kyhx/Multi-voltage-output-power-KYHX/PCB_PCB1_2026-10-07.pdf

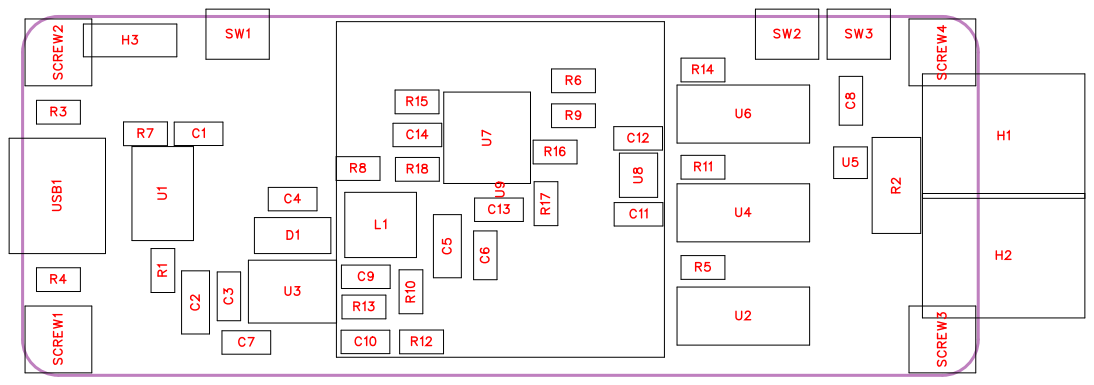
[picture p1: page 1]

No. | Quantity | Comment | Designator | Footprint | Value | Manufacture r Part | Manufacture r | Supplier Part | Supplier
1 | 1 | 1uF | C1 | C0805 | 1uF | CL21B105KBF NNNE | SAMSUNG( ) C28323 | | LCSC
2 | 1 | 22uF | C2 | C1206 | 22uF | CL31A226KAH NNNE | SAMSUNG( ) C12891 | | LCSC
3 | 2 | 100nF | C3,C6 | C0805 | 100nF | CC0805KRX7R 9BB104 | YAGEO(ýè) | C49678 | LCSC
4 | 4 | 100nF | C4,C8,C13,C14 | C0805 | 100nF | FCC0805B104 K500DT | FOJAN(Ìw) | C5137467 | LCSC
5 | 1 | 100uF | C5 | C1206 | 100uF | CL31A107MQH NNNE | SAMSUNG( ) C15008 | | LCSC
6 | 1 | 8.2nF | C7 | C0805 | 8.2nF | 0805B822K50 0NT | FH(ÎN) | C1758 | LCSC
7 | 1 | 2.2nF | C9 | C0805 | 2.2nF | 0805B222K50 0NT | FH(ÎN) | C36576 | LCSC
8 | 1 | 10pF | C10 | C0805 | 10pF | CC0805JRNPO 9BN100 | YAGEO(ýè) | C107107 | LCSC
9 | 2 | 1nF | C11,C12 | C0805 | 1nF | CC0805KRX7R 9BB102 | YAGEO(ýè) | C94121 | LCSC
10 | 1 | B340A-E3/61 T | D1 | SMA_L4.3-W2 .6-LS5.2-RD | | B340A-E3/61 T | VISHAY() | C15570 | LCSC
11 | 2 | PZ254R-12-8 P | H1,H2 | HDR-TH_8P-P 2.54-H-M-R2 -C4-S2.54 | | PZ254R-12-8 P | XFCN(tÞ) | C492432 | LCSC
12 | 1 | LAIL-PZ2.54 -3P-L | H3 | HDR-TH_3P-P 2.54-V-M-1 | | LAIL-PZ2.54 -3P-L | LAILAN(±T) | C54950604 | LCSC
13 | 1 | FXL0530-6R8 -M | L1 | IND-SMD_L5. 4-W5.2_FXL0 530 | | FXL0530-6R8 -M | cjiang(•_®5) Tj | T* () C177249 | LCSC
14 | 2 | 10k© | R1,R8 | R0805 | 10k© | FRC0805F100 2TS | FOJAN(Ìw) | C2907219 | LCSC
15 | 1 | 20m© | R2 | R2512 | 20m© | CSM2512FT20 L0 | SEI(Stackpo) Tj | T* (le) Tj T* (Electronics) Tj | LCSC | T* (Inc.) C346458
16 | 2 | 5.1k© | R3,R4 | R0805 | 5.1k© | 0805W8F5101 T5E | UNI-ROYAL(š) Tj | T* (ð) C27834 | LCSC
17 | 3 | 330© | R5,R11,R14 | R0805 | 330© | 0805W8F3300 T5E | UNI-ROYAL(š) Tj | T* (ð) C17630 | LCSC
18 | 3 | 10k© | R6,R15,R18 | R0805 | 10k© | 0805W8F1002 T5E | UNI-ROYAL(š) Tj | T* (ð) C17414 | LCSC
19 | 1 | 1k© | R7 | R0805 | 1k© | ERJPB6B1001 V | PANASONIC(~) Tj | T* () C413712 | LCSC
20 | 1 | 3.3k© | R9 | R0805 | 3.3k© | 0805W8F3301 T5E | UNI-ROYAL(š) Tj | T* (ð) C26010 | LCSC
21 | 1 | 10.2k© | R10 | R0805 | 10.2k© | FRC0805F102 2TS | FOJAN(Ìw) | C2933282 | LCSC

22 | 1 | 3.24k© | R12 | R0805 | 3.24k© | 0805W8F3241 T5E | UNI-ROYAL(š) Tj | T* (ð) C17609 | LCSC
23 | 1 | 13.7k© | R13 | R0805 | 13.7k© | 0805W8F1372 T5E | UNI-ROYAL(š) Tj | T* (ð) C17448 | LCSC
24 | 2 | 4.7k© | R16,R17 | R0805 | 4.7k© | FRC0805J472 TS | FOJAN(Ìw) | C2907326 | LCSC
25 | 4 | M3º | SCREW1,SCREW2,SCREW3,SCR EW4 | M3º
26 | 3 | HX TS24CA-H3.8 160gf | SW1,SW2,SW3 | SW-SMD_TS24 CA | | HX TS24CA-H3.8 160gf | hanxia(é) | C25168830 | LCSC
27 | 1 | CH224K | U1 | ESSOP-10_L4 .9-W3.9-P1. 0-LS6.0-TL-EP | | CH224K | WCH(W¬•R) | C970725 | LCSC
28 | 3 | GAQY212GHAU2,U4,U6 | | SMD-4_L6.5-W4.6-P2.54-LS9.6-TL-1 | | GAQY212GHASUPSiC(ýv®J) Tj | | T* (üS) C19271987 | LCSC
29 | 1 | TPS54331DR U3 | | SOIC-8_L5.0 -W4.0-P1.27 -LS6.0-BL | | TPS54331DR | TI(·Þêh) | C9865 | LCSC
30 | 1 | INA199A1DCK R | U5 | SC-70-6_L2. 2-W1.3-P0.6 5-LS2.1-BR | | INA199A1DCK R | TI(·Þêh) | C59135 | LCSC
31 | 1 | STM32F070F6 P6 | U7 | TSSOP-20_L6 .5-W4.4-P0. 65-LS6.4-BL | | STM32F070F6 P6 | ST(ÕJüS) | C86951 | LCSC
32 | 1 | TLV75718PDB VR | U8 | SOT-23-5_L3 .0-W1.7-P0. 95-LS2.8-BR | | TLV75718PDB VR | TI(·Þêh) | C507270 | LCSC
33 | 1 | HS96L03W2C0 3 | U9 | OLED-TH_L27 .8-W27.2-P2 .54_C990003 3791 | | HS96L03W2C0 3 | HS(I) | C5248080 | LCSC
34 | 1 | TYPE-C16PINUSB1 | | USB-C-SMD_T YPE-C16PIN | | TYPE-C16PINSHOU | HAN(–é) | C393939 | LCSC

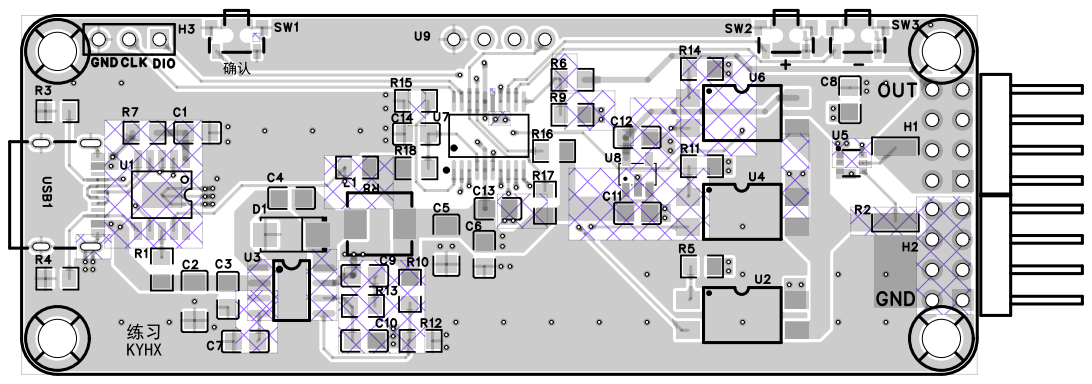
[picture p2: page 5]

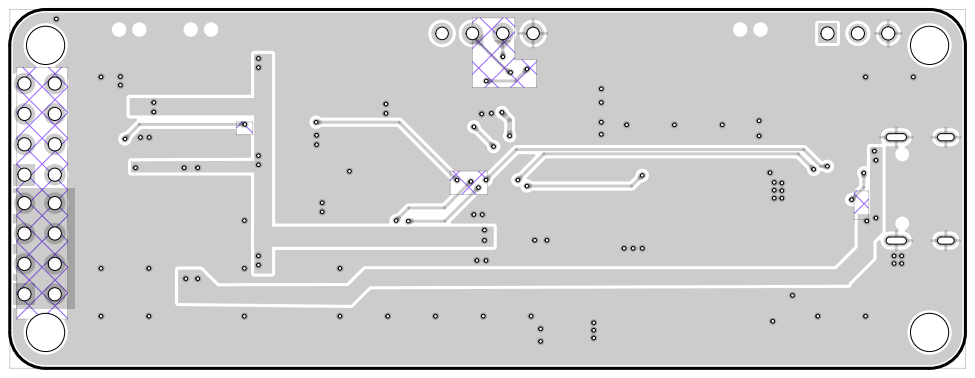
[picture p3: page 6]

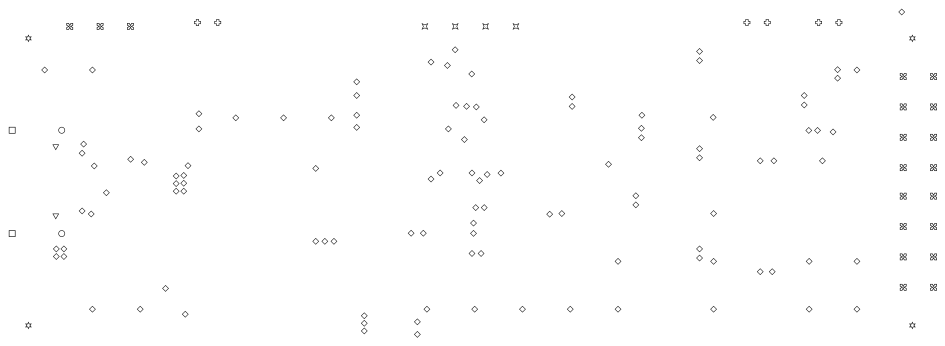
[picture p4: page 7]
