kyhx/Multi-voltage-output-power-KYHX/数字电源学习板原理图.pdf

| | | GND | A1B12 VBUS A4B9 CC1 A5 DP1 A6 DN1 A7 SBU1 A8 CC2 B5 DP2 B6 DN2 B7 SBU2 B8 VBUS B4A9 GND B1A12 SHELL 1 | | | | | | | | | 50V | | 1uF | | PG 10 | | DM | 5 | | | | R0805 | | | | R5 | | U2 | | | VBUS | | | R2512 | | R6 | | | | | 7 8

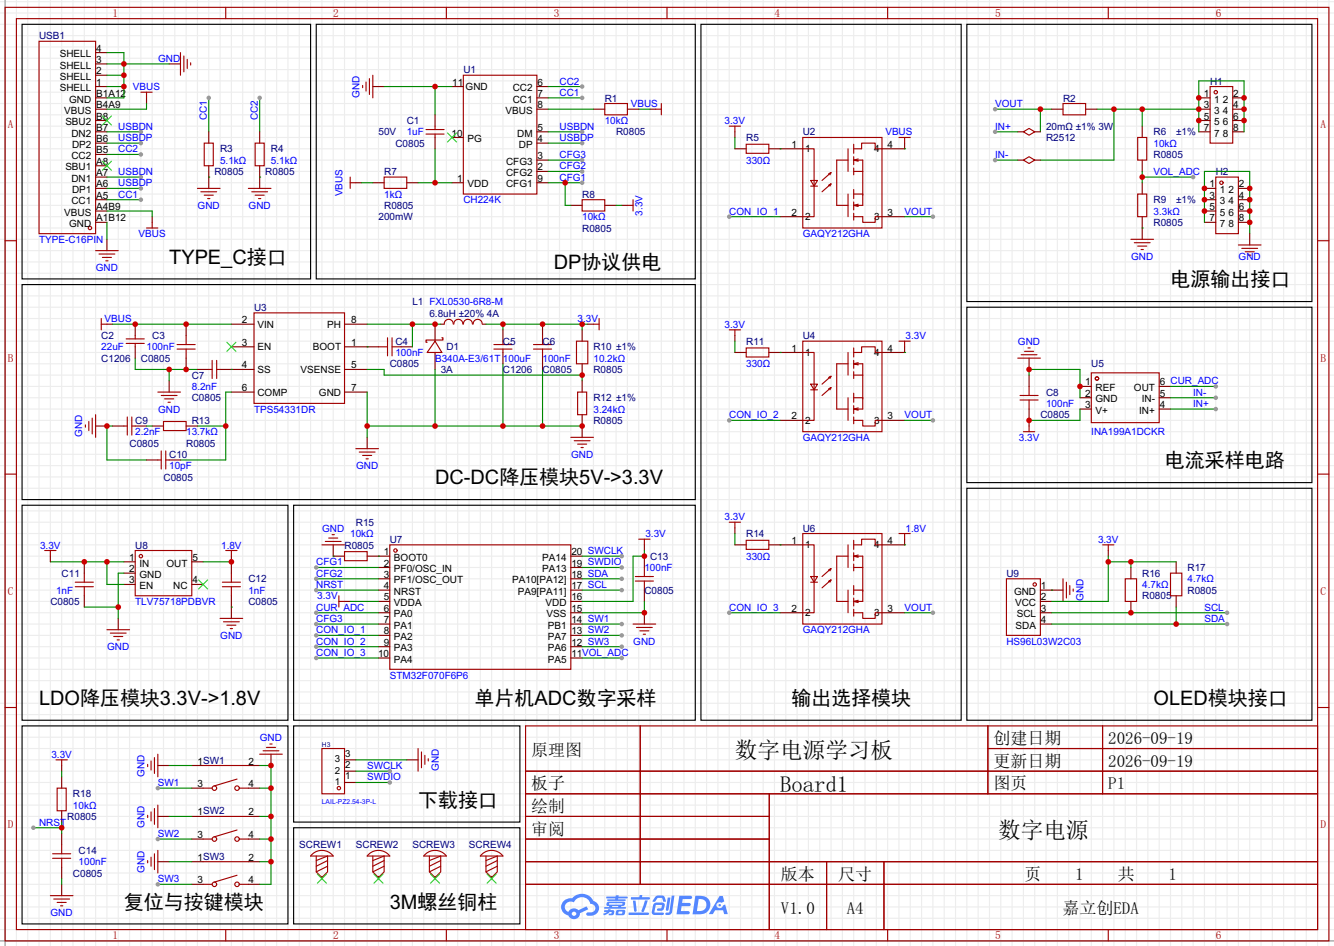
[picture p5: page 1]

USB1
SHELL | 4
SHELL | 3 | | | | U1
SHELL | 2 | | | | | | | | CC2 | | | | | H1

VBUS | | | GND 11 | CC2 | 6 | | | | | 1 | | 2

CC1 | 7 | | | R1 | | VBUS | | | | | | | | | | VOUT | | R2 | | | | 3 | | 1 2 | 4
VBUS | | 8 | | | | | | | | | | | | | | | | | | | | | 5 | | 3 4 | 6

A | | | | | USBDN | | | | | | | | | | C1 | | | | | | USBDN | | 10kΩ | | | 3.3V | | | | | | | | | IN+ | 20mΩ ±1% 3W | | | | | 7 | | 5 6 | 8 | | A

USBDP | | | | | | | | | | | | | | | | USBDP
CC2
USBDN | | | R0805 | | | R0805 | | R7 | | | | | CFG2 | | 2 | CFG2 | | | | | | | | | | | | | | | | | VOL_ADC | | | | | H2
VDD 1 | CFG1 | | 9 | CFG1 | | | | | | | | | | | | | | | | | | | | | 1 | | | 2
USBDP
CC1

R3 | | R4 | | | C0805 | | | | | DP | 4 | | | | | | | | | 1 | | 1 | 4 | 4 | | | | | | 10kΩ
5.1kΩ | | | 5.1kΩ | | | | | | CFG3 | | 3 | CFG3 | | | | | | | 330Ω | | | | | | | IN- | | | | R0805

GND | | | GND | | | R0805 | | | CH224K | | | | | | | | | | | | | | | | | | | | | | | R9 | ±1% | | 3 | 3 | 4 | 4

200mW | | | | | | | | | 10kΩ | | | | | CON_IO_1 | | 2 | | 2 | 3 | 3 | VOUT | | | | | 3.3kΩ | | | | 5 | 6

TYPE-C16PIN | | | | VBUS | | | | | | | | | | | | | | | | | | | | | | | | GAQY212GHA

TYPE_C接口 | DP协议供电 | GND | | GND

GND

电源输出接口

VBUS | | | | | | | | | | | | 6.8uH ±20% 4A

U3 | | | | | | L1 | FXL0530-6R8-M
VIN 2 | | | PH | 8 | | | | | | | | | | 3.3V

C2 | | | | C3 | | | | | | | | | | | | C5 | C6 | | | | | R11 | | U4 | | | | 3.3V | GND
22uF | | | 100nF | | | EN 3 | | BOOT | | 1 | | | | | D1 | | | R10 | ±1% | | | | 1 | | 1 | 4 | 4

C7
8.2nF | | | | | | | | | | | | | | | | | | | | | | | | | | | REF 1 | OUT | 6 | CUR_ADC
C0805 | COMP 6 | | GND | | 7 | | | | | | | | R12 | ±1% | | | | | | | | | | | | C8 | GND 2 | IN- | 5 | | IN-

SS 4 | VSENSE | | | 5 | | | | 3A | | C1206 | C0805 | R0805

GND | | TPS54331DR | | | | | | | | | | | | 3.24kΩ | | | | | | | | | | | | | 100nF | V+ 3 | IN+ | 4 | | IN+

R13 | | | | | | | | | | | | | R0805 | | | CON_IO_2 | | 2 | | 2 | 3 | 3 | VOUT | | C0805
13.7kΩ
C0805 | | DC-DC降压模块5V->3.3V

C0805 | R0805 | | GAQY212GHA | 3.3V

INA199A1DCKR

GND | | 电流采样电路

U8 | | | | 1.8V | | | | R0805 | | U7 | | | | | | | | | 1 | | 1 | 4 | 4 | | | | 3.3V
C | 1nF | | | | EN 3 | | NC 4 | | 1nF | NRST | | | | PA4 10 NRST 4 | PA5 | 11 PA6 12 PA7 13 PB1 14 VSS 15 VDD 16 PA9[PA11] 17 PA10[PA12] 18 PA13 19 PA14 20 | SCL | C0805 | | | | | | | | | | | | GND 1 | | | 4.7kΩ | | R0805 | | C

GND | 10kΩ | | | | | | | | | | R14 | | U6 | | | | 1.8V 3.3V

BOOT0 1 | | | SWCLK | | C13 | | | 330Ω

IN 1 | OUT 5 | | | | CFG1 | | | | PF0/OSC_IN 2 | | | SWDIO | 100nF | | | | | | | | | | | | | | | | R17

C11 | | | GND 2 | | | | C12 | CFG2 | | | | PF1/OSC_OUT 3 | | | SDA | | | | | | | | | | | | U9 | | | R16 | | 4.7kΩ
C0805 | | | TLV75718PDBVR | | | | | C0805 | | | | | VDDA 5 | | | | | | | | | | | | | | | HS96L03W2C03 GND | VCC 2 | | | R0805

CUR_ADC | | | | PA0 6 | | | | | | | CON_IO_3 | | 2 | | 2 | 3 | 3 | VOUT | | SCL 3 | | | | | | SCL
CFG3 | | | | PA1 7 | | | SW1 | | | | | | | | | | | | | SDA 4 | | | | | | SDA

GND | | CON_IO_1 | | | | PA2 8 | | | SW2 | | | | | | | GAQY212GHA

GND | | | | | | | CON_IO_2 | | | | PA3 9 | | | SW3 | GND

CON_IO_3 | | | | | | | VOL_ADC

H3 | | | | 原理图 | 数字电源学习板 | 创建日期 | 2026-09-19

3.3V | SW1 | | | 3 | 3 | | | | 更新日期 | 2026-09-19

1 | 2 | | 2 | 2 | SWCLK
SW1 | 3 | 4 | 1 | 1 | SWDIO | 板子 | Board1 | 图页 | P1

R18
10kΩ | | | | | LAIL-PZ2.54-3P-L | | 下载接口 | | 绘制
R0805 | | | 1 SW2 | 2

D | NRST | | | | | | | | | | | 审阅 | | | 数字电源 | | | | | D

C14 | | | | SCREW1 | | SCREW2 | SCREW3 | SCREW4
100nF | | SW3 1 | 2
C0805 | | | | | | | | | | 版本 | 尺寸 | | 页 | 1 | 共 | 1
复位与按键模块 | 3M螺丝铜柱 | V1.0 | A4 | 嘉立创EDA
