kyhx/Multi-voltage-output-power-KYHX/立创开源-多路输出电源板-v2.0.pdf

默认5V输出 | 0.02R*1.5A*50倍=1.5V

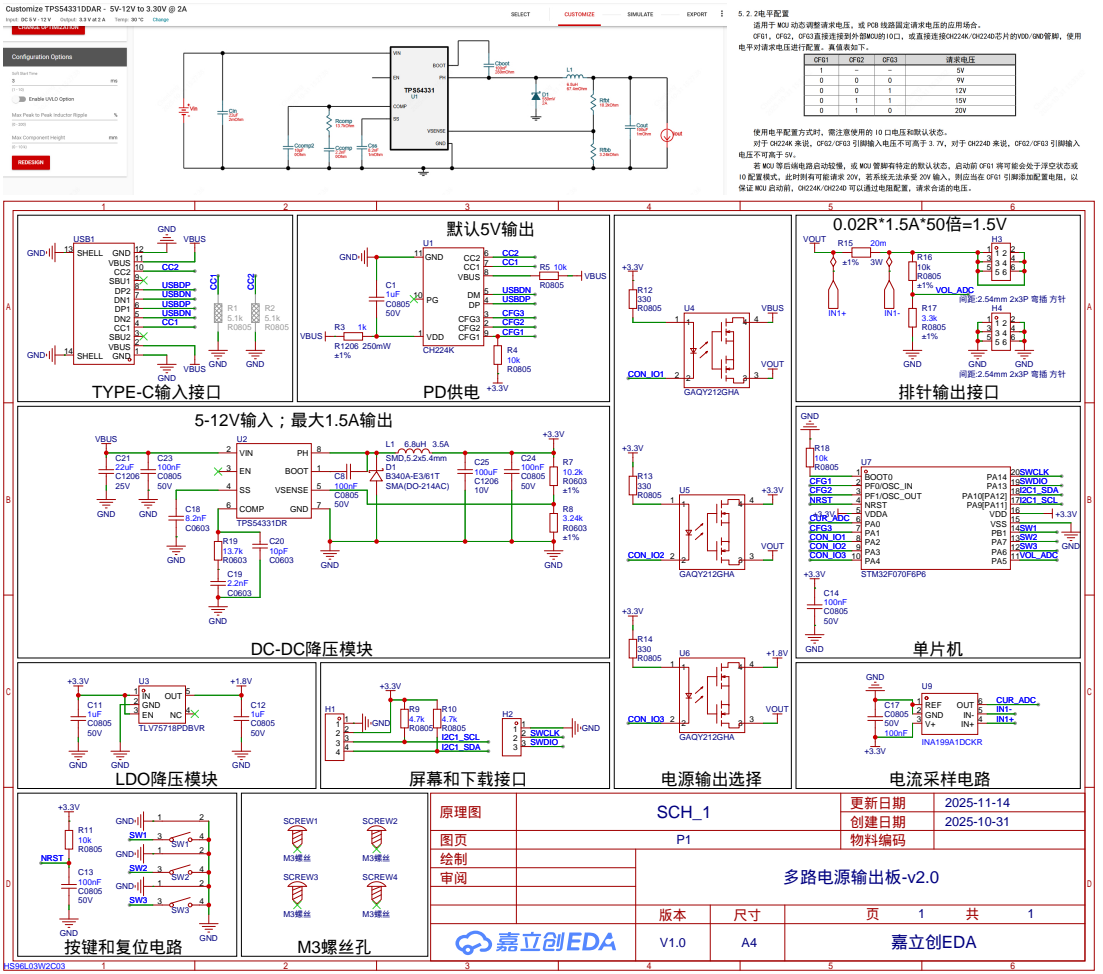
[picture p6: page 1]
