kyhx/Multi-voltage-output-power-KYHX/mult-output-power-v2.0/Core/Inc/main.h

#define CFG1_Pin GPIO_PIN_0
#define CFG1_GPIO_Port GPIOF
#define CFG2_Pin GPIO_PIN_1
#define CFG2_GPIO_Port GPIOF
#define CFG3_Pin GPIO_PIN_1
#define CFG3_GPIO_Port GPIOA
#define CON_IO1_Pin GPIO_PIN_2
#define CON_IO1_GPIO_Port GPIOA
#define CON_IO2_Pin GPIO_PIN_3
#define CON_IO2_GPIO_Port GPIOA
#define CON_IO3_Pin GPIO_PIN_4
#define CON_IO3_GPIO_Port GPIOA
#define SW3_Pin GPIO_PIN_6
#define SW3_GPIO_Port GPIOA
#define SW3_EXTI_IRQn EXTI4_15_IRQn
#define SW2_Pin GPIO_PIN_7
#define SW2_GPIO_Port GPIOA
#define SW2_EXTI_IRQn EXTI4_15_IRQn
#define SW1_Pin GPIO_PIN_1
#define SW1_GPIO_Port GPIOB
#define SW1_EXTI_IRQn EXTI0_1_IRQn
