kyhx/Multi-voltage-output-power-KYHX/mult-output-power-v2.0/middle/mid_oled.h

#ifndef __OLED_H
#define __OLED_H

#include "main.h"

#define OLED_COM_PORT	hi2c1
#define OLED_ADDR		0X78

#define OLED_CMD  0	//write cmd
#define OLED_DATA 1	//write data

#define normal_display  1	//normal display
#define reverse_display 0	//inverse display

void OLED_ClearPoint(uint8_t x,uint8_t y);
void OLED_ColorTurn(uint8_t i);
void OLED_DisplayTurn(uint8_t i);
void OLED_WR_Byte(uint8_t dat,uint8_t mode);
void OLED_DisPlay_On(void);
void OLED_DisPlay_Off(void);
void OLED_Refresh(void);
void OLED_Clear(void);
void OLED_DrawPoint(uint8_t x,uint8_t y,uint8_t t);
void OLED_DrawLine(uint8_t x1,uint8_t y1,uint8_t x2,uint8_t y2,uint8_t mode);
void OLED_DrawCircle(uint8_t x,uint8_t y,uint8_t r);
void OLED_ShowChar(uint8_t x,uint8_t y,uint8_t chr,uint8_t size1,uint8_t mode);
void OLED_ShowChar6x8(uint8_t x,uint8_t y,uint8_t chr,uint8_t mode);
void OLED_ShowString(uint8_t x,uint8_t y,uint8_t *chr,uint8_t size1,uint8_t mode);
void OLED_ShowNum(uint8_t x,uint8_t y,uint32_t num,uint8_t len,uint8_t size1,uint8_t mode);
void OLED_Init(void);
#endif
