kyhx/Multi-voltage-output-power-KYHX/(commit log)

2026-10-04 提交说明：项目上传
2026-10-07 Add files via upload
    上传PCB
