kyhx/Multi-voltage-output-power-KYHX/(notices)

Notices in the files:
mult-output-power-v2.0/Core/Inc/main.h:
Copyright (c) 2025 STMicroelectronics.
All rights reserved.
This software is licensed under terms that can be found in the LICENSE file
